AhmedSobhy01/convolution-accelerator/README.md

# Convolution Accelerator

A high-performance hardware accelerator for 2D convolution operations, designed as part of the **CMP3020 VLSI course**. This project implements a streaming coprocessor architecture that efficiently performs convolution operations under tight on-chip memory constraints.

## 📋 Table of Contents

- [Overview](#overview)
- [Project Features](#project-features)
- [Architecture](#architecture)
- [Project Structure](#project-structure)
- [Getting Started](#getting-started)
- [Physical Implementation (RTL-to-GDS)](#physical-implementation-rtl-to-gds)
- [Design Specifications](#design-specifications)
- [Documentation](#documentation)
- [Future Work](#future-work)
- [Team Contributions](#team-contributions)

---

## Overview

This project presents a **Weight Stationary (WS) dataflow** architecture optimized for 2D convolution acceleration. Rather than implementing a straightforward convolution approach, the design evolved through analysis, failed assumptions, and trade-offs, much like a real hardware development process.

### Key Innovation

The accelerator addresses the challenge of limited on-chip memory by:
- Using kernel folding to decompose large kernels (up to 16×16) into smaller blocks (8×8)
- Accumulating partial results across multiple passes
- Employing a split-kernel approach that distributes computation across multiple phases

### Use Case

The accelerator is designed as a streaming coprocessor that:
- Accepts input image and kernel data from external DRAM
- Performs efficient 2D convolution operations
- Returns output results to DRAM
- Works in tight integration with a host system

---

## Project Features

### 🔧 Core Components

- **8×8 Systolic Array** - Parallel processing element array for MAC operations
- **Dual-Port SRAM Architecture** - Concurrent read/write for efficient data movement
  - SRAM0 (64-bit × 1024): Image and kernel storage
  - SRAM1 (32-bit × 4096): Packed partial output buffer
- **DMA-Based Data Loading** - Efficient data movement from external DRAM
- **Split-Kernel Support** - Handles kernels up to 16×16 on 8×8 array
- **Column-Major Output** - Memory-efficient streaming of results
- **Control Unit FSM** - Orchestrates complex multi-phase kernel execution

### 📊 Performance Metrics

Signed off with **OpenLane 2 / SkyWater sky130A** at an 80 ns (12.5 MHz) clock:
DRC-clean, LVS-clean, and timing met. Full details in
[Physical_Implementation.md](docs/Physical_Implementation.md) and [Metrics.md](docs/Metrics.md).

| Metric | Value |
|---|---|
| DRC (KLayout `sky130A_mr`) | 0, pass |
| LVS (Netgen) | 0 errors, pass |
| Setup slack (slow corner) | +13.0 ns, met |
| Hold | met |
| Total power at 80 ns | 0.091 W |
| Die / core area | 18.0 / 17.1 mm² |
| Core utilization | 28.3% |
| SRAM macros | 20 (4 of 32×512, 16 of 32×256) |
| Array dimension | 8×8 |
| Max kernel size | 16×16 |
| Supported image size | up to 64×64 |

---

## Architecture

### System Overview

ba5d1150-3803-4dfe-b6b3-72ebcee24833

### Data Flow Phases

1. **Load Phase**: DRAM image and kernel loaded into SRAM0 via DMA
2. **Kernel Streaming**: 8×8 kernel blocks streamed to systolic array
3. **Convolution**: SA computes partial contributions for each kernel block
4. **Writeback**: Partial results accumulated in SRAM1 using byte-masked writes
5. **Drain Phase**: Final results summed and streamed back to DRAM

### Split-Kernel Approach

For kernels larger than 8×8:
- **Phase A**: Top-left 8×8 kernel block → partial output
- **Phase B**: Top-right 8×8 kernel block → accumulated
- **Phase C**: Bottom-left 8×8 kernel block → accumulated
- **Phase D**: Bottom-right 8×8 kernel block → accumulated

Final output = sum of all partial contributions

---

## Project Structure

```
convolution-accelerator/
├── rtl/                           # RTL Design Files (Verilog)
│   ├── conv_accelerator_top.v     # Top-level module
│   ├── control_unit/              # FSM-based control unit
│   ├── data-loader-agu/           # Data loader and AGU
│   │   ├── src/                   # Core streaming modules
│   │   ├── Python_scripts/        # Helper scripts for memory generation
│   │   └── designs/               # SRAM design files
│   ├── systolic_array/            # Systolic array implementation
│   │   ├── pe.v                   # Processing element
│   │   └── systolic_array.v       # 8×8 array
│   └── tb/                        # Testbenches
│
├── config/                        # OpenLane hardening configuration
│   ├── config.json                # RTL-to-GDS flow parameters
│   ├── macro_placement.cfg        # SRAM macro placement
│   └── runs/                      # Generated flow runs (output, git-ignored)
│
├── docs/                          # Documentation (architecture, metrics, flow)
│
├── scripts/                       # Simulation + verification scripts
│   └── run_all_tests.py, verify*  # Functional test/verify helpers
│
├── test_cases/                    # Test configurations (01 -> 10)
│
└── sim/                           # Simulation scripts
```

---

## Getting Started

### Prerequisites

- **Verilog/SystemVerilog** simulator (ModelSim, VCS, etc.)
- **Python 3.x** (for test generation and verification scripts)
- **Make** or equivalent build tool (optional)

### Running Simulations

#### 1. Simulate Individual Components

**Systolic Array Test:**
```bash
cd rtl/systolic_array
vsim -do ../../sim/systolic_array_sim.do
```

**Processing Element Test:**
```bash
cd rtl/systolic_array
vsim -do ../../sim/pe_sim.do
```

**Control Unit Test:**
```bash
cd rtl/control_unit
vsim -do run_tb.do
```

#### 2. Run Full System Tests

```bash
cd scripts
python3 run_all_tests.py
```

This will:
- Load test configurations from `test_cases/`
- Generate stimulus data
- Run full integration simulations
- Compare outputs with golden references

#### 3. Verify Output

```bash
bash scripts/verify.sh
```

### Physical Implementation (RTL-to-GDS)

The accelerator is hardened to GDSII with **OpenLane 2** on the **SkyWater
sky130A** PDK. The flow is driven by `config/config.json` and produces a
**DRC-clean, LVS-clean, timing-met** layout. See
[docs/Physical_Implementation.md](docs/Physical_Implementation.md) for the full
flow, configuration rationale, and the SRAM-macro signoff fixes.

```bash
# Launch the full RTL-to-GDS flow (output lands in config/runs/<tag>/)
openlane config/config.json --run-tag my_run

# Follow the live flow log
tail -f config/runs/my_run/flow.log
```

A run succeeds when `config/runs/<tag>/final/` appears, containing
`final/gds/conv_accelerator_top.gds` plus DEF/LEF/LIB/SDC/SDF/SPEF/SPICE views.

---

## Design Specifications

### Top-Level Module: `conv_accelerator_top`

#### Parameters
| Parameter | Default | Description |
|---|---|---|
| `ADDR_W` | 10 | SRAM0 word address width (1024 words) |
| `BYTE_ADDR_W` | 13 | Byte address width (8 KB) |
| `KER_BASE_BYTE` | 4096 | Kernel base address in SRAM0 |
| `IMG_BASE_BYTE` | 0 | Image base address in SRAM0 |
| `SRAM1_ADDR_W` | 12 | SRAM1 word address width (4096 words) |
| `SA_DIM` | 8 | Systolic array dimension |
| `SA_INPUT_FILL_TIME` | 8 | SA pipeline fill time |

#### Port Interface

```verilog
// Inputs
input clk                    // System clock
input rst_n                  // Active-low reset
input start                  // Start convolution operation
input [6:0] cfg_N           // Image dimension (N×N)
input [4:0] cfg_K           // Kernel dimension (K×K)
input [7:0] rx_data         // Input data from DRAM
input rx_valid              // Input data valid signal
input tx_ready              // Output ready signal

// Outputs
output done                 // Convolution complete
output rx_ready             // Ready to accept input data
output tx_valid             // Output data valid
output [7:0] tx_data        // Output data to DRAM
```

### Memory Architecture

#### SRAM0 (64-bit × 1024 words)
- Stores full input image and kernel weights
- Dual-port for concurrent reads
- Image stored from address 0
- Kernel stored from address 4096 (configurable)

#### SRAM1 (32-bit × 4096 words)
- Stores packed partial outputs
- 4 bytes per pixel (one byte per kernel phase)
- Byte-masked writes enable atomic lane updates
- No read-modify-write cycles required

### Timing Constraints

The hardened design closes timing cleanly at an **80 ns clock (12.5 MHz)**:

| Metric | Value |
|---|---|
| Clock period | 80 ns (12.5 MHz) |
| Worst Setup Slack (slow corner) | +13.0 ns, met |
| Setup / Hold violations | 0 / 0 |

> The clock was tightened from an earlier 150 ns point, which met timing with
> about 46 ns of unused slack. 80 ns is the fastest clean operating point from
> configuration alone. Going faster (70 ns) keeps setup positive but introduces
> small hold violations, so beyond 80 ns needs RTL pipelining of the
> systolic-array drain path.

---
## Key Design Decisions

### Weight Stationary Dataflow

The final architecture employs **Weight Stationary (WS)** rather than Output Stationary (OS) because:
- Kernel is reused across the entire input image
- Keeping weights fixed in PEs minimizes redundant weight movement
- Simplifies kernel loading and reduces data communication
- Well-suited for single-kernel, large-input-image scenarios

### Split-Kernel Approach

For kernels larger than 8×8:
- Decompose into 8×8 sub-kernels
- Process sequentially through multiple phases
- Accumulate partial outputs in SRAM1
- Final results obtained by summing all partial contributions

### Dual-Port SRAM Strategy

- **SRAM0 (64-bit)**: Optimized for unaligned window reads and kernel loading
- **SRAM1 (32-bit)**: Packed output format with byte-lane isolation
- Enables pipelined data movement without pipeline stalls

## Documentation

For detailed information, refer to the documentation files:

- **[Comprehensive_Architecture.md](docs/Comprehensive_Architecture.md)** - Complete system architecture and module descriptions
- **[Convolution Accelerator.md](docs/Convolution%20Accelerator.md)** - Project journey, design decisions, and architectural evolution
- **[Memory Organization.md](docs/Memory%20Organization.md)** - SRAM layout, address generation, and memory mapping
- **[Control Unit.md](docs/Control%20Unit.md)** - FSM design and state transitions
- **[Systolic Array Documentation](docs/Systolic%20Array/)** - Detailed PE and array specifications
- **[Physical_Implementation.md](docs/Physical_Implementation.md)** - RTL-to-GDS (OpenLane/sky130) flow, configuration, and signoff fixes
- **[Metrics.md](docs/Metrics.md)** - PPA (Power, Performance, Area) & signoff results
- **[Team_Contributions.md](docs/Team_Contributions.md)** - Team member roles and module ownership

---
## Future Work
The team is currently looking into 2 other implementations that are expected to improve the performance metrics even more.

1) DiP Architectured systolic arrays\
Referenced from this paper: https://arxiv.org/pdf/2412.09709 \
current work can be found in this branch: [feat/sa-dip](https://github.com/AhmedSobhy01/convolution-accelerator/tree/feat/sa-dip)\
It basically works by eliminating the input/output synchronization FIFOs required by state-of-the-art weight stationary systolic arrays by adopting diagonal input movement and weight permutation.



2) A slight timing adjustment on the current 101 implementation\
Inspired after reading this article: https://telesens.co/2018/07/30/systolic-architectures \
current work progress can be found in this branch: [feat/sa-101-optimized](https://github.com/AhmedSobhy01/convolution-accelerator/tree/feat/sa-101-optimized)

---
## References

This project implements concepts from CNN accelerator literature, including:
- Systolic array design principles
- Dataflow mapping techniques for convolution
- Memory hierarchy optimization for embedded systems

---
## Team Contributions

<table align="center">
<tr>
  <td align = "center"> 
	<a href = "https://github.com/AhmedSobhy01">
	  
	  <br />
	  <sub> Ahmed Sobhy </sub>
	</a>
  </td>

  <td align = "center"> 
	<a href = "https://github.com/AhmedAmrNabil">
	  
	  <br />
	  <sub> AhmedAmrNabil </sub>
	</a>
  </td>
  
  <td align = "center"> 
	<a href = "https://github.com/ahmedfathy0-0">
	  
	  <br />
	  <sub> Ahmed Fathy </sub>
	</a>
  </td>

  <td align = "center"> 
	<a href = "https://github.com/ZiadMontaser">
	  
	  <br />
	  <sub> Ziad Montaser</sub>
	</a>
  </td>
</tr>
</table>

<table align="center">
<tr>

  <td align = "center"> 
	<a href = "https://github.com/Tasneemmohammed0">
	  
	  <br />
	  <sub> Tasneem Mohamed </sub>
	</a>
  </td>
  
  <td align = "center"> 
	<a href = "https://github.com/habibayman">
	  
	  <br />
	  <sub> Habiba Ayman </sub>
	</a>
  </td>
  <td align = "center"> 
	<a href = "https://github.com/tonynagyy">
	  
	  <br />
	  <sub> Tony Nagy </sub>
	</a>
  </td>

  <td align = "center"> 
	<a href = "https://github.com/HelanaNady">
	  
	  <br />
	  <sub> Helana Nady</sub>
	</a>
  </td>
</tr>
</table>
