AhmedSobhy01/convolution-accelerator/rtl/data-loader-agu/designs/SRAM_32_4096_1_grid/32x4096-MT-32x256.png

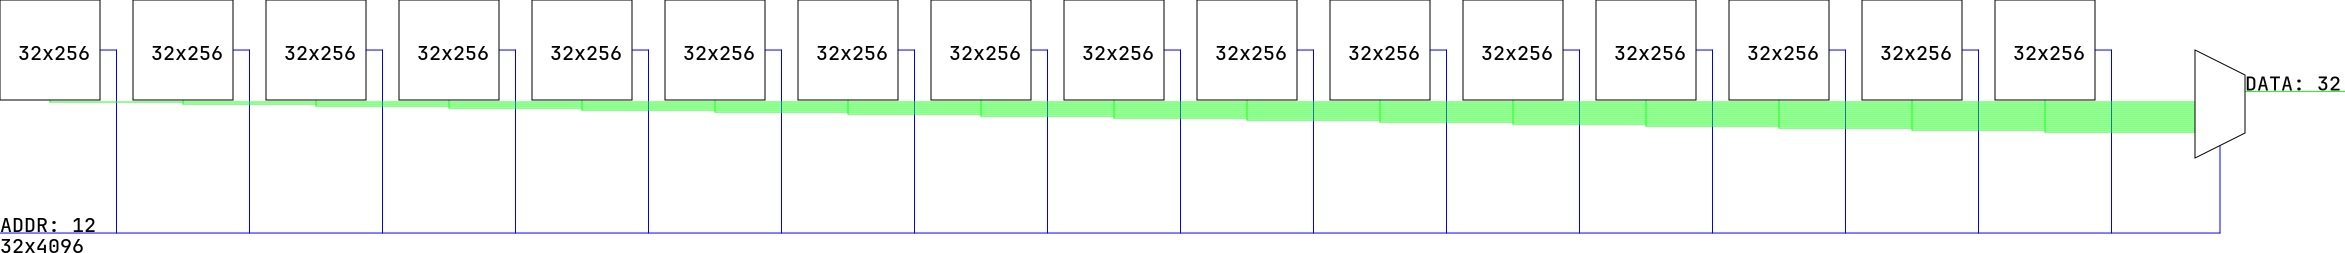
rtl/data-loader-agu/designs/SRAM_32_4096_1_grid/32x4096-MT-32x256.png
