AhmedSobhy01/convolution-accelerator/rtl/data-loader-agu/designs/SRAM_64_1024_2_grid/64x1024-MT-32x512.png

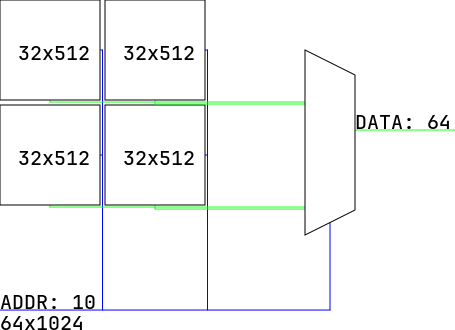
rtl/data-loader-agu/designs/SRAM_64_1024_2_grid/64x1024-MT-32x512.png
