AhmedSobhy01/convolution-accelerator/docs/Team Contributions.pdf

## Convolution Accelerator - Team Contributions

## Project Team

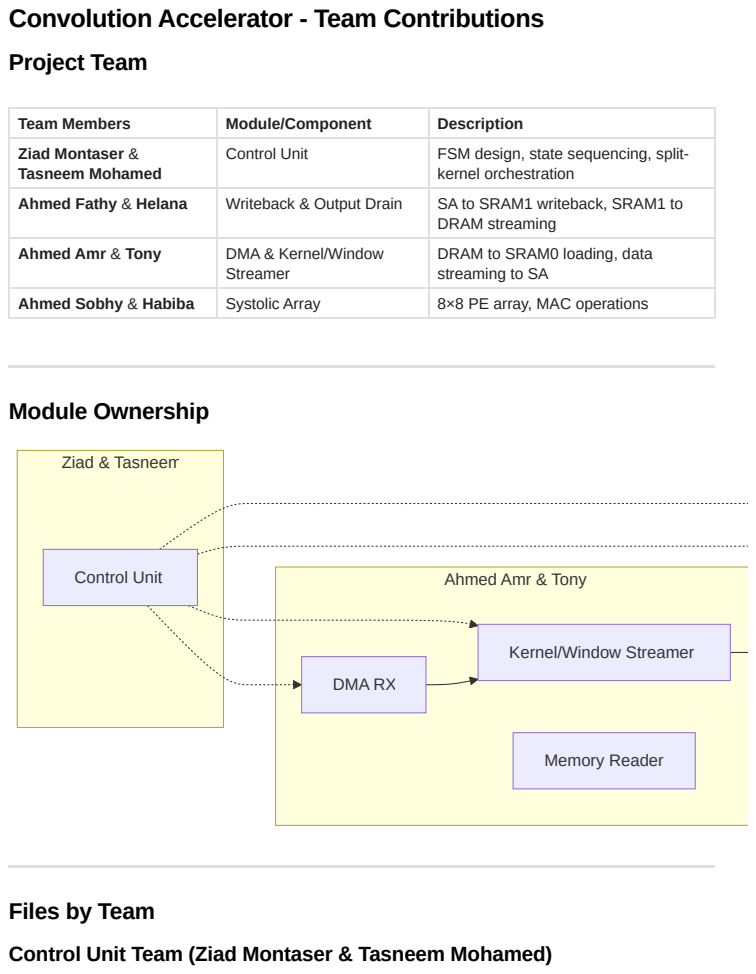
[picture p3: page 1]
Module Ownership; Ziad & Tasneem; Control Unit; DMA RX; Memory Reader

Team Members | Module/Component | Description
Ziad Montaser & Tasneem Mohamed | Control Unit | FSM design, state sequencing, split-kernel orchestration

Ahmed Fathy & Helana | Writeback & Output Drain | SA to SRAM1 writeback, SRAM1 to DRAM streaming

Ahmed Amr & Tony | DMA & Kernel/Window Streamer | DRAM to SRAM0 loading, data streaming to SA

Ahmed Sobhy & Habiba | Systolic Array | 8×8 PE array, MAC operations

Ahmed Amr & Tony

Kernel/Window Streamer

Files by Team

Control Unit Team (Ziad Montaser & Tasneem Mohamed)

## DMA & Streamer Team (Ahmed Amr & Tony)

## Systolic Array Team (Ahmed Sobhy & Habiba)

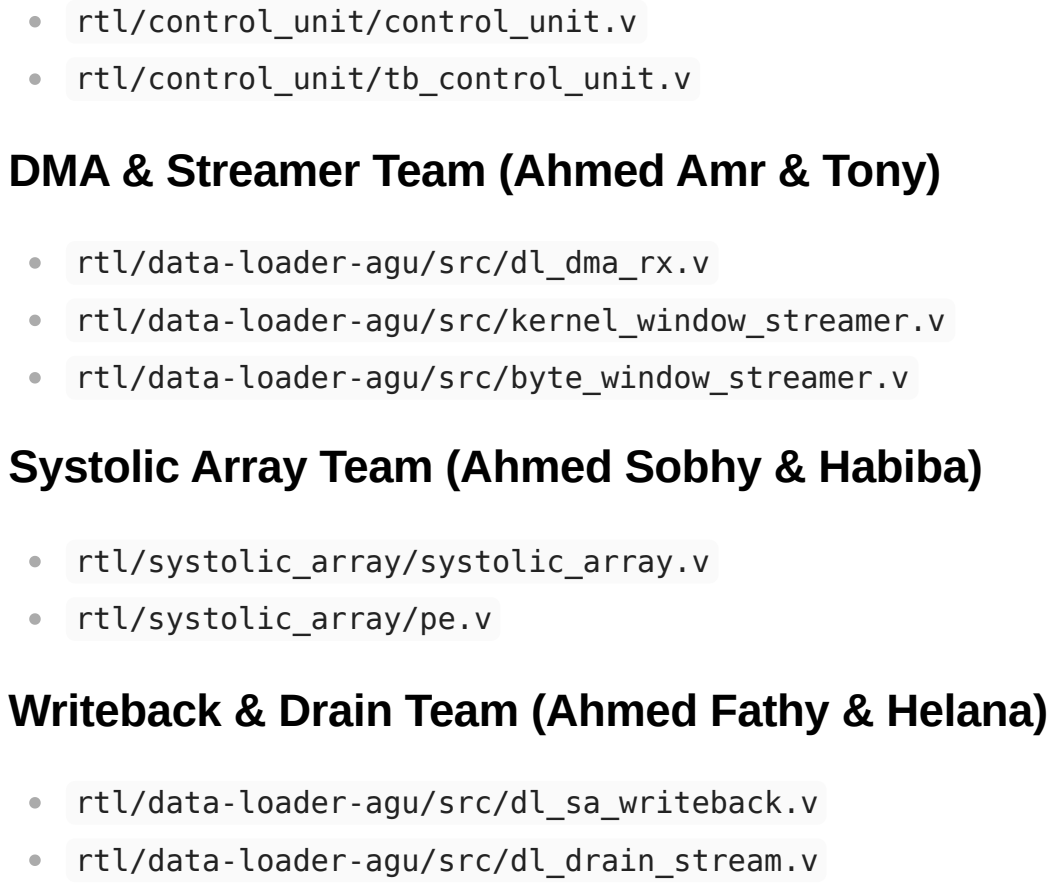
[picture p4: page 2]
rtl/control_unit/control_unit.v; rtl/control_unit/tb_control_unit.v

rtl/data-loader-agu/src/dl_dma_rx.v
rtl/data-loader-agu/src/kernel_window_streamer.v
rtl/data-loader-agu/src/byte_window_streamer.v

rtl/systolic_array/systolic_array.v
rtl/systolic_array/pe.v
Writeback & Drain Team (Ahmed Fathy & Helana)

rtl/data-loader-agu/src/dl_sa_writeback.v
rtl/data-loader-agu/src/dl_drain_stream.v
