AhmedSobhy01/convolution-accelerator/docs/Comprehensive Architecture.pdf

# Convolution Accelerator - Comprehensive Architecture Documentation

## Table of Contents

## System Overview

This convolution accelerator is a hardware implementation for 2D convolution operations, commonly used in CNNs. It processes an N×N image with a K×K kernel to produce an (N-K+1)×(N-K+1) output.

## Key Features

1. System Overview
2. Top-Level Architecture
3. Data Flow Pipeline
4. Module Deep Dive
5. Testbench Operation
6. Timing & Control

8×8 Systolic Array for parallel MAC operations
Dual-port SRAM architecture for concurrent read/write DMA-based data loading from external DRAM Split-kernel support for kernels larger than 8×8 (up to 16×16) Column-major output for memory-efficient streaming

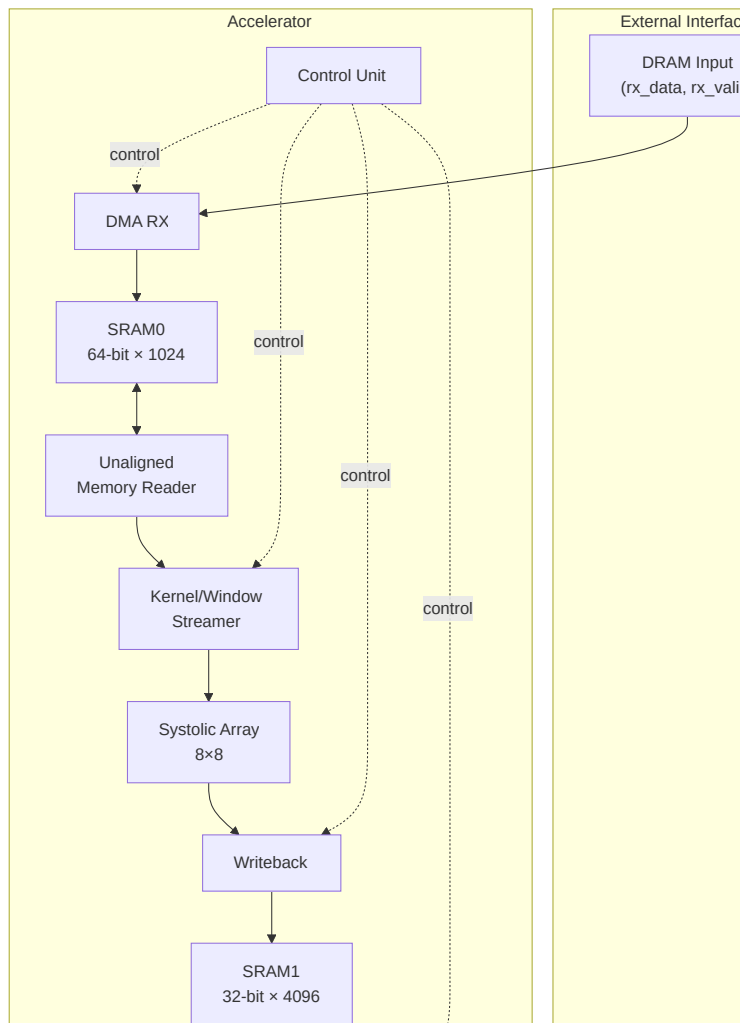
[picture p5: page 2]
Accelerator; External Interfac; control; DRAM Input (rx_data, rx_vali; DMA RX; SRAM0 64-bit × 1024; Unaligned Memory Reader; Kernel/Window Streamer; Systolic Array 8×8; Writeback; SRAM1 32-bit × 4096; Control Unit

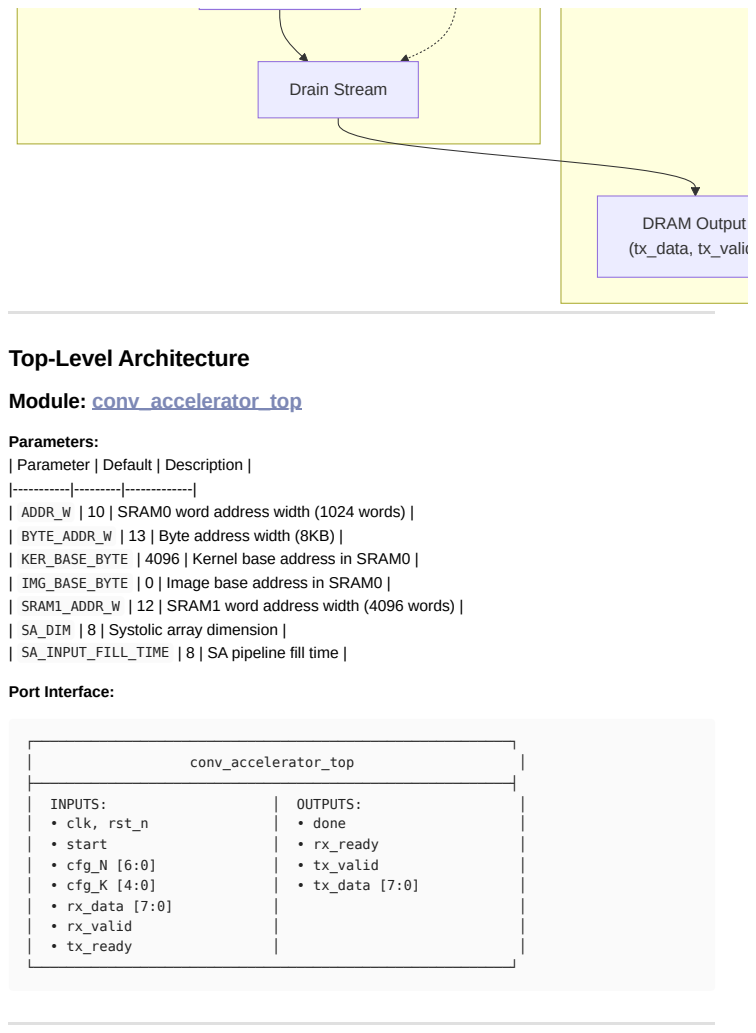
[picture p6: page 3]
DRAM Output (tx_data, tx_valid; Drain Stream; Module: conv_accelerator_top; Port Interface:; conv_accelerator_top; │ INPUTS:; │ OUTPUTS:; │ • clk, rst_n; │ • done; │ • start; │ • rx_ready; │ • cfg_N [6:0]; │ • tx_valid; │ • cfg_K [4:0]; │ • tx_data [7:0]; │ • rx_data [7:0]; │ • rx_valid; │ • tx_ready

Top-Level Architecture

Parameters:
Parameter | Default | Description
ADDR_W | 10 | SRAM0 word address width (1024 words)
BYTE_ADDR_W | 13 | Byte address width (8KB)
KER_BASE_BYTE | 4096 | Kernel base address in SRAM0
IMG_BASE_BYTE | 0 | Image base address in SRAM0
SRAM1_ADDR_W | 12 | SRAM1 word address width (4096 words)
SA_DIM | 8 | Systolic array dimension
SA_INPUT_FILL_TIME | 8 | SA pipeline fill time

## Data Flow Pipeline

## Phase 1: Data Loading (DRAM → SRAM0)

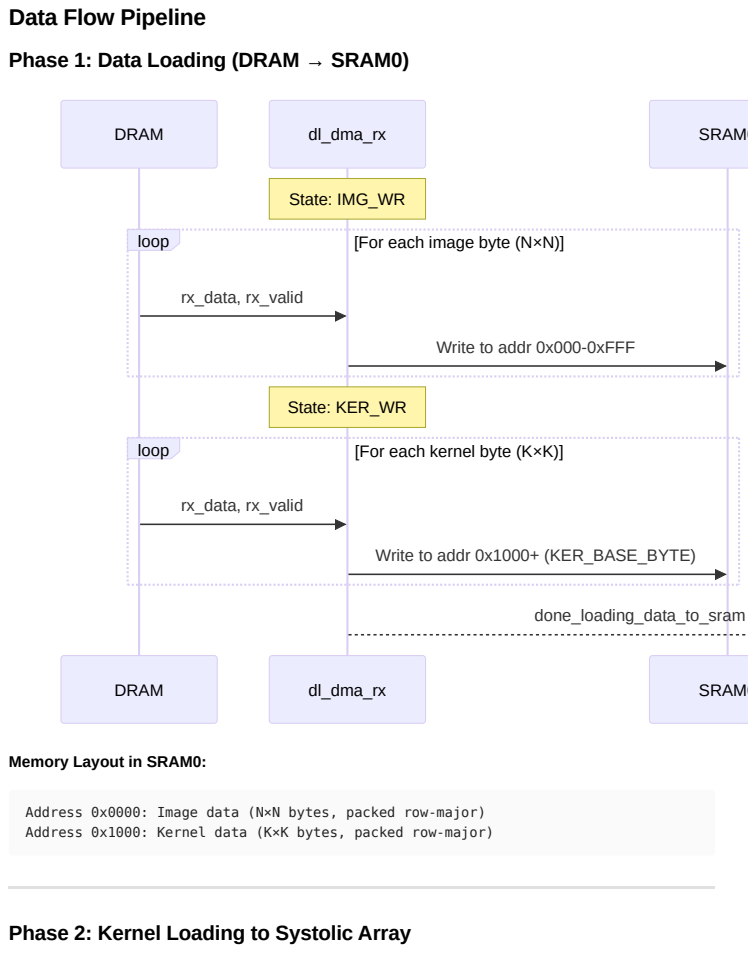
[picture p7: page 4]
DRAM; dl_dma_rx; SRAM0; State: IMG_WR; loop; [For each image byte (N×N)]; State: KER_WR; [For each kernel byte (K×K)]; rx_data, rx_valid; done_loading_data_to_sram

Write to addr 0x000-0xFFF

Write to addr 0x1000+ (KER_BASE_BYTE)

Memory Layout in SRAM0:

Address 0x0000: Image data (N×N bytes, packed row-major)
Address 0x1000: Kernel data (K×K bytes, packed row-major)

Phase 2: Kernel Loading to Systolic Array

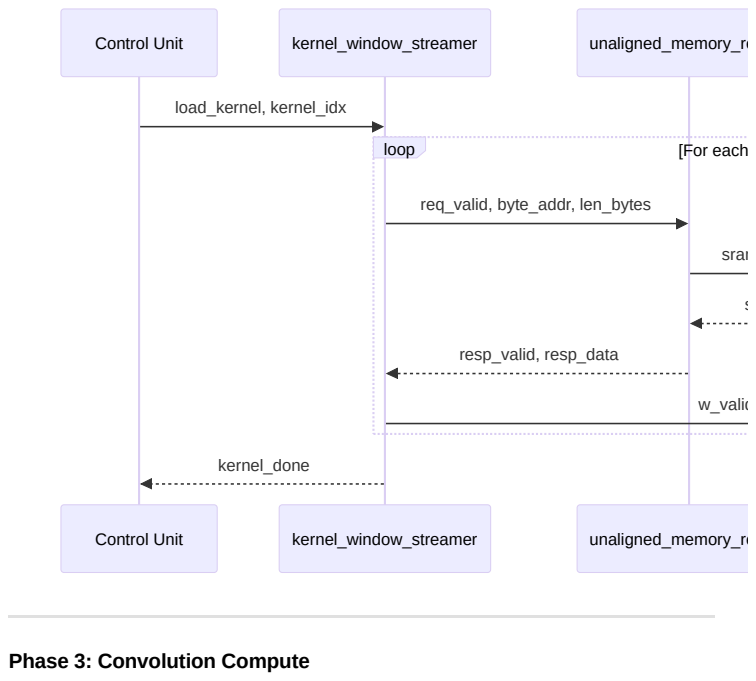
[picture p8: page 5]
Control Unit; kernel_window_streamer; unaligned_memory_re; loop; [For each; load_kernel, kernel_idx; req_valid, byte_addr, len_bytes; sram; resp_valid, resp_data; w_valid; kernel_done

Phase 3: Convolution Compute

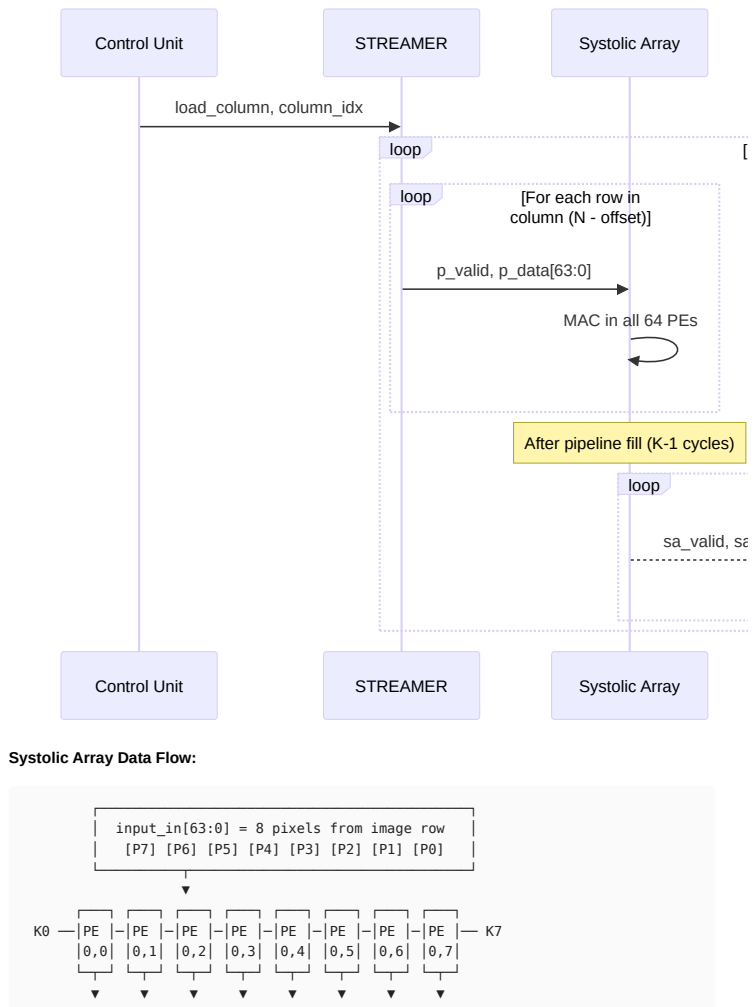
[picture p9: page 6]
Control Unit; STREAMER; Systolic Array; loop; [For each row in; column (N - offset)]; load_column, column_idx; p_valid, p_data[63:0]; sa_valid, sa; │ input_in[63:0] = 8 pixels from image row

MAC in all 64 PEs

After pipeline fill (K-1 cycles)

Systolic Array Data Flow:

## Phase 4: Result Drain (SRAM1 → DRAM)

┌───┐ ┌───┐ ┌───┐ ┌───┐ ┌───┐ ┌───┐ ┌───┐ ┌───┐
K8 ──│PE │─│PE │─│PE │─│PE │─│PE │─│PE │─│PE │─│PE │── K15 │1,0│ │1,1│ │1,2│ │1,3│ │1,4│ │1,5│ │1,6│ │1,7│ └─┬─┘ └─┬─┘ └─┬─┘ └─┬─┘ └─┬─┘ └─┬─┘ └─┬─┘ └─┬─┘
⋮ | ⋮ | ⋮ | ⋮ | ⋮ | ⋮ | ⋮ | ⋮

Each PE: out_partial = kernel_weight × input_pixel
Sum of all 64 partials → output pixel (clamped to 8 bits)

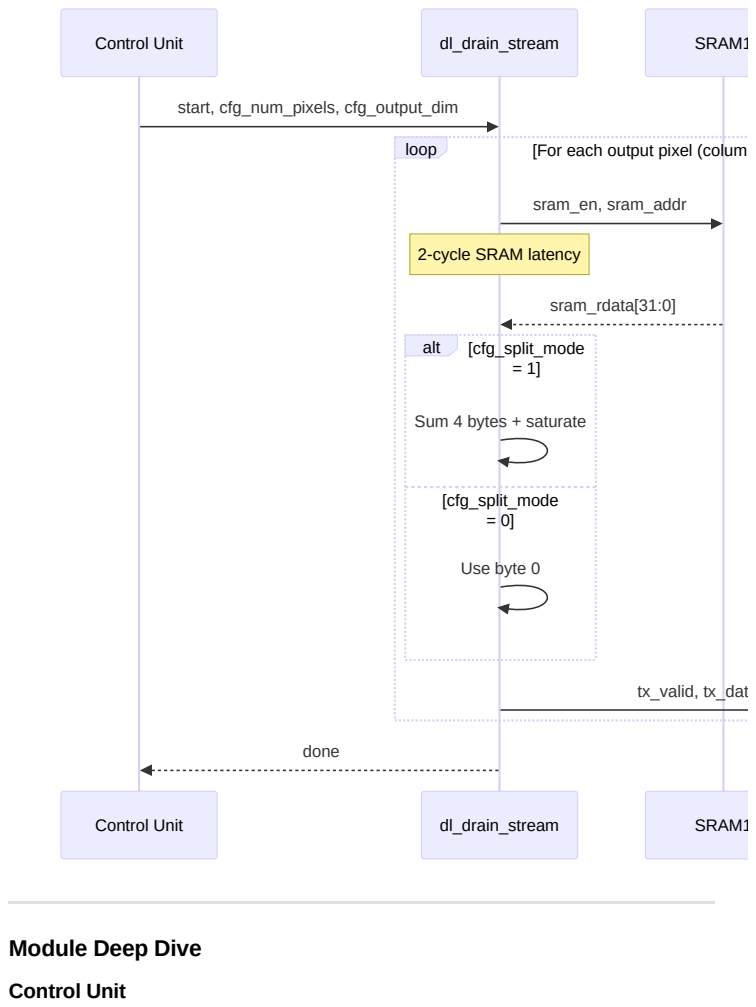
[picture p10: page 8]
Control Unit; dl_drain_stream; SRAM1; alt; [cfg_split_mode; [cfg_split_mode = 0]; loop; [For each output pixel (colum; start, cfg_num_pixels, cfg_output_dim; sram_en, sram_addr; sram_rdata[31:0]; Use byte 0; tx_valid, tx_dat; done

2-cycle SRAM latency

Sum 4 bytes + saturate

Module Deep Dive

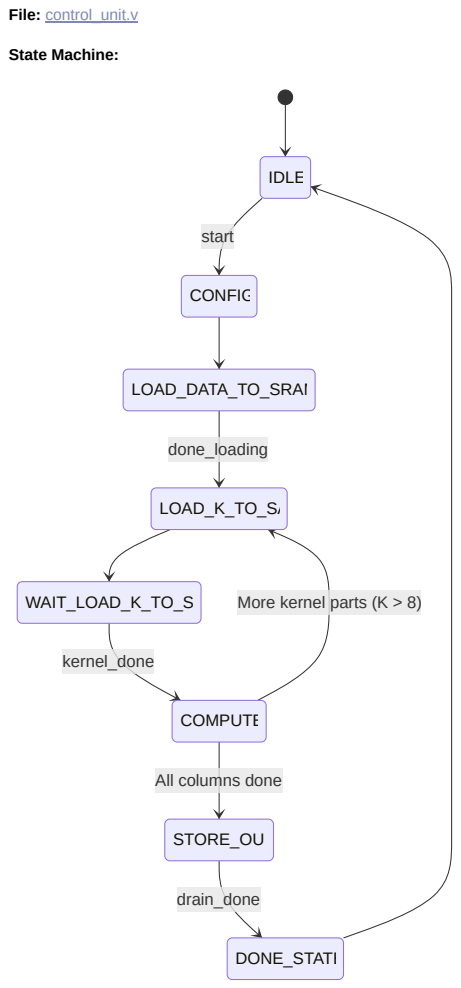
[picture p11: page 9]
File: control_unit.v; State Machine:; start; done_loading; kernel_done; drain_done; IDLE; CONFIG; LOAD_DATA_TO_SRAM; LOAD_K_TO_SA; WAIT_LOAD_K_TO_S; COMPUTE; STORE_OU; DONE_STATE

More kernel parts (K > 8)

All columns done

Split-Kernel Support (K > 8):
When kernel size exceeds SA dimension, kernel is split into 4 quadrants:

## DMA RX Module

File: dl_dma_rx.v

Receives byte-wide data from DRAM and packs into 64-bit SRAM words.

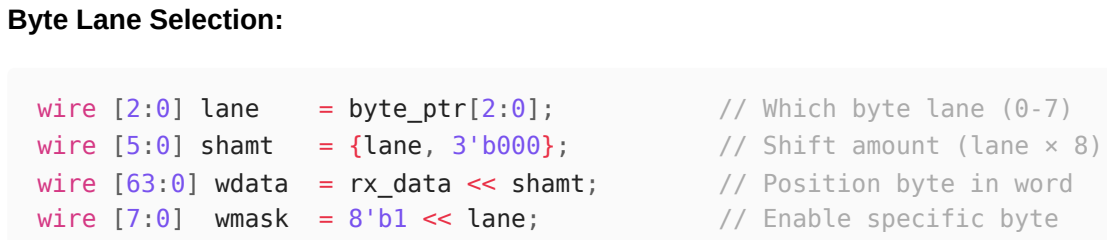
[picture p12: figure]
Byte Lane Selection:; wire [2:0] lane; = byte_ptr[2:0];; // Which byte lane (0-7)

## Unaligned Memory Reader

File: byte_window_streamer.v

Reads arbitrary byte-aligned data from 64-bit SRAM. Uses both SRAM ports to handle cross-word-boundary reads.

┌───────────────┬───────────────┐
│ Quadrant 0 | │ Quadrant 1 | │
│ (idx=0) | │ (idx=1) | │
│ Top-Left | │ Top-Right | │
├───────────────┼───────────────┤
│ Quadrant 2 | │ Quadrant 3 | │
│ (idx=2) | │ (idx=3) | │
│ Bottom-Left | │ Bottom-Right │
└───────────────┴───────────────┘
wire [5:0] shamt | = {lane, 3'b000}; | // Shift amount (lane × 8)
wire [63:0] wdata = rx_data << shamt; | // Position byte in word
wire [7:0] wmask = 8'b1 << lane; | // Enable specific byte

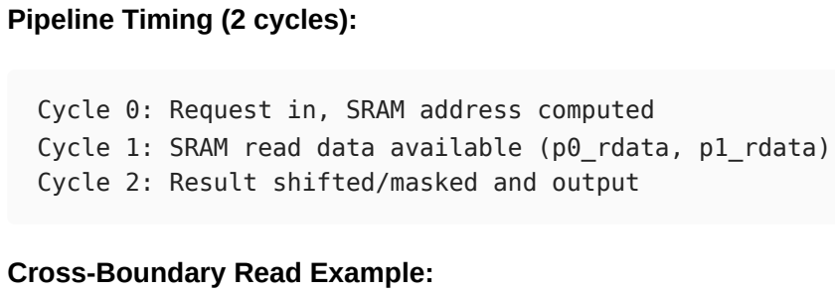
[picture p13: figure]
Pipeline Timing (2 cycles):; Cross-Boundary Read Example:

Cycle 0: Request in, SRAM address computed
Cycle 1: SRAM read data available (p0_rdata, p1_rdata) Cycle 2: Result shifted/masked and output

## Kernel/Window Streamer

File: kernel_window_streamer.v

Orchestrates data streaming for both kernel loading and image window streaming.

Two Modes:

## Processing Element (PE)

File: pe.v

Each PE performs a single multiply operation per cycle.

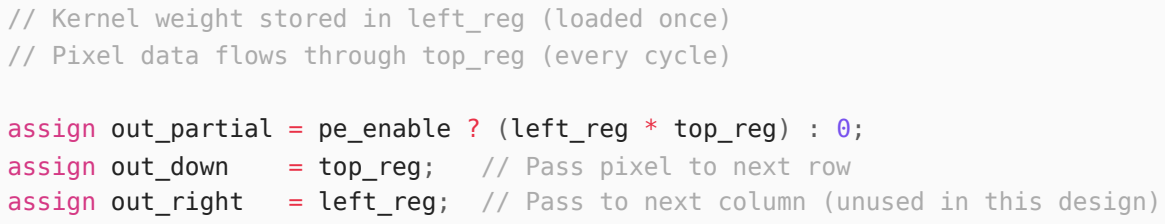
[picture p14: figure]

## Systolic Array

File: systolic_array.v

8×8 array of PEs computing dot product of kernel × image window.

Output Computation:

SRAM Word N+1: [B7 B6 B5 B4 B3 B2 B1 B0]

Combined: | [Word N+1 | Word N] >> 40 & 0xFFFFFFFF
1. LOAD_KERNEL: Reads kernel rows from KER_BASE_BYTE
2. STREAM_WIN: Reads image columns from IMG_BASE_BYTE + column offset

// Kernel weight stored in left_reg (loaded once)
// Pixel data flows through top_reg (every cycle)

assign out_partial = pe_enable ? (left_reg * top_reg) : 0;
assign out_down | = top_reg; | // Pass pixel to next row
assign out_right | = left_reg; // Pass to next column (unused in this design)

// Sum all 64 partial products always @(*) begin

## SA Writeback

File: dl_sa_writeback.v

Buffers SA outputs and writes to SRAM1 using byte-lane masking for split-kernel accumulation.

FIFO Buffer: 8-entry × 8-bit to absorb SA output burst

Address Stride: Increments by 1 word per write (kernel_idx selects byte lane for accumulation)

## Drain Stream

File: dl_drain_stream.v

Reads output from SRAM1 and streams to DRAM byte-by-byte.

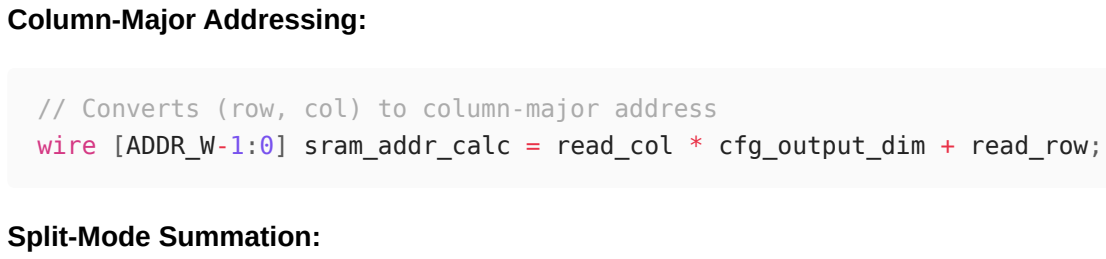
[picture p15: figure]
Column-Major Addressing:; Split-Mode Summation:

When K > 8, four partial results are summed with saturation:

## Testbench Operation

## File: tb_conv_accel_simple.v

Test Case Structure:

sum_partials = 0;
for (n = 0; n < 8; n = n + 1) for (m = 0; m < 8; m = m + 1)
sum_partials = sum_partials + pe_out_partials[n][m]; end

// Converts (row, col) to column-major address
wire [ADDR_W-1:0] sram_addr_calc = read_col * cfg_output_dim + read_row;

sum_temp = sram_rdata[7:0] + sram_rdata[15:8] +

computed_pixel = (sum_temp > 255) ? 8'hFF : sum_temp[7:0];

Test Flow:

test_cases/
├── 01_Basic_Minimal_config.txt ├── 01_Basic_Minimal_in.hex ├── 01_Basic_Minimal_weight.hex ├── 02_Basic_Identity_config.txt ├── ...
└── 10_Pro_Saturation_*.{txt,hex}

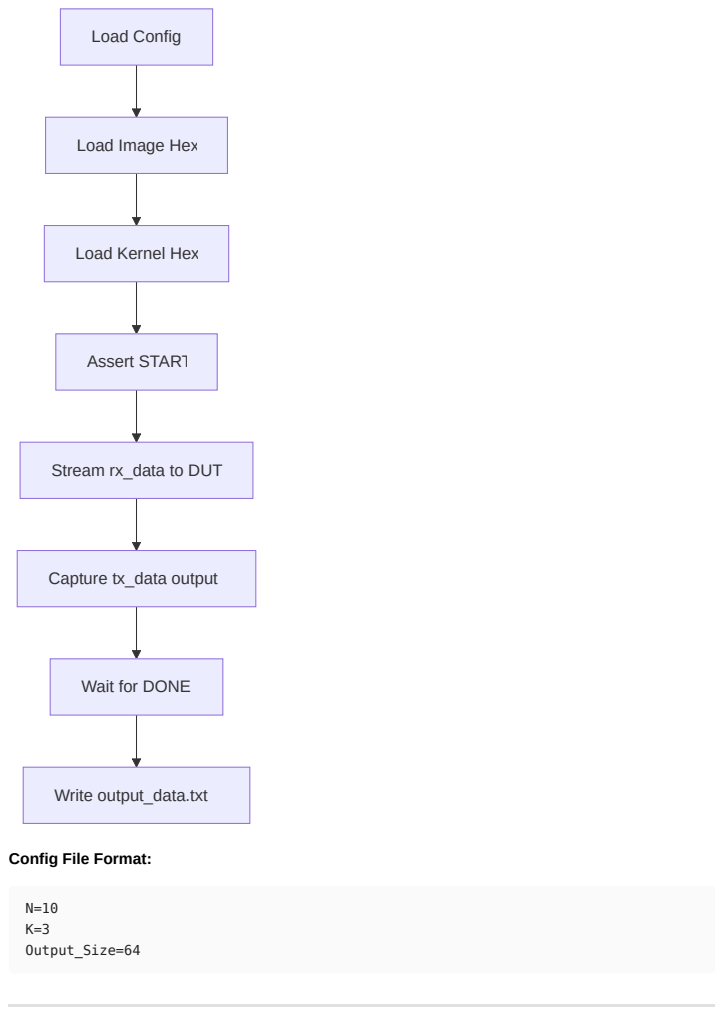
[picture p16: page 14]
Load Config; Assert START; Capture tx_data output; Write output_data.txt; N=10 K=3 Output_Size=64

Load Image Hex

Load Kernel Hex

Stream rx_data to DUT

Wait for DONE

Config File Format:

## Timing & Control

## Pipeline Latency Summary

Stage | Latency (cycles)
DMA Write to SRAM | 1
Memory Reader | 2
SA Pipeline Fill | K-1 (or half-K for split)
SA Valid Delay | SA_INPUT_FILL_TIME + SA_DIM
Writeback FIFO | 0-8 (depends on fill)
Drain SRAM Read | 2

## Control Signals Timing

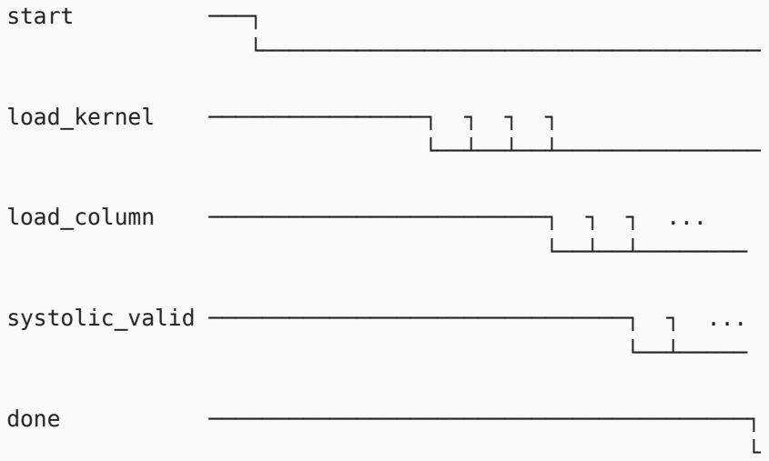
[picture p17: figure]
start; load_kernel; load_column; systolic_valid ───────────────────────────────┐ ┐ ... └──┴─────; done

## Memory Map

## SRAM0 (Input Buffer - 8KB)

Address Range | Content
0x0000 - 0x0FFF | Image data (N×N bytes)
0x1000 - 0x10FF | Kernel data (K×K bytes)

## SRAM1 (Output Buffer - 16KB)

Address Range | Content
0x000 - 0xFFF | Output pixels (column-major, 1 byte/word for normal, 4 bytes/word for split)

## Configuration Constraints

Parameter | Min | Max | Notes
N (Image Size) | 2 | 64 | Power of 2 recommended
K (Kernel Size) | 1 | 16 | Split mode for K > 8
Output Size | 1 | 63 | = N - K + 1
