AhmedSobhy01/convolution-accelerator/rtl/conv_accelerator_top.v

`timescale 1ns/1ps

module conv_accelerator_top #(
  parameter ADDR_W = 10,              // SRAM0 word address width (1024 words)
  parameter BYTE_ADDR_W = 13,         // Byte address width (8KB)
  parameter KER_BASE_BYTE = 16'd4096,
  parameter IMG_BASE_BYTE = 16'd0,
  parameter SRAM1_ADDR_W  = 12,       // SRAM1 word address width (4096 words)
  parameter SA_DIM = 8,               // Systolic array dimension
  parameter SA_INPUT_FILL_TIME = 8    // SA fill time
)(
  input  wire         clk,
  input  wire         rst_n,

  // High-level control interface
  input  wire         start,          // Start convolution operation
  input  wire [6:0]   cfg_N,          // Image size (control unit)
  input  wire [4:0]   cfg_K,          // Kernel size (control unit)
  output wire         done,           // Operation complete

  // DRAM input stream (32-bit) -> SRAM0
  input  wire [7:0]  rx_data,
  input  wire         rx_valid,
  output wire         rx_ready,

  // DRAM output stream (8-bit) <- SRAM1
  output wire         tx_valid,
  output wire [7:0]   tx_data,
  input  wire         tx_ready
`ifdef USE_POWER_PINS
  ,
  inout wire          vccd1,          // Power  (connected to PDN via VDD_NETS)
  inout wire          vssd1           // Ground (connected to PDN via GND_NETS)
`endif
);

  // Systolic Array Interface
  // Outputs TO SA
  wire         w_valid;        // kernel/weight data valid
  wire [63:0]  w_data;         // kernel column vector
  wire         p_valid;        // pixel data valid
  wire [63:0]  p_data;         // pixel row vector

  // Inputs FROM SA (Results)
  wire         sa_out_valid;
  wire [7:0]   sa_out_data;
  wire         sa_wb_busy;     // Writeback buffer full

  // ============================================
  // Power Pins
  // ============================================
  // vccd1/vssd1 are top-level inout ports (declared in the port list under
  // USE_POWER_PINS) and are hooked to the power grid by OpenLane via
  // VDD_NETS/GND_NETS. They must not be supply0/supply1 constants, otherwise
  // the SRAM macro power inouts get driven by constants (flatten error).

  // ============================================
  // Control Unit Signals
  // ============================================
  wire [6:0]   cu_cfg_N;
  wire [4:0]   cu_cfg_K;
  wire         cu_start_load;
  wire         cu_load_done;
  wire         cu_start_pass;
  wire         cu_load_kernel;
  wire [1:0]   cu_kernel_idx;
  wire         cu_kernel_done;
  wire         cu_load_column;
  wire [6:0]   cu_column_idx;
  wire         cu_start_drain;
  wire         cu_drain_done;
  wire         cu_systolic_valid;
  wire         window_done;      // streamer -> control unit column-load handshake

  // ============================================
  // SRAM0 Signals (Input Buffer)
  // ============================================
  wire         sram0_p0_en;
  wire         sram0_p0_we;
  wire [ADDR_W-1:0] sram0_p0_addr;
  wire [63:0]  sram0_p0_wdata;
  wire [7:0]   sram0_p0_wmask;
  wire [63:0]  sram0_p0_rdata;

  wire         sram0_p1_en;
  wire [ADDR_W-1:0] sram0_p1_addr;
  wire [63:0]  sram0_p1_rdata;

  // ============================================
  // SRAM1 Signals (Output Buffer)
  // ============================================
  wire         sram1_p0_en;
  wire         sram1_p0_we;
  wire [SRAM1_ADDR_W-1:0] sram1_p0_addr;
  wire [31:0]  sram1_p0_wdata;
  wire [3:0]   sram1_p0_wmask;
  wire [31:0]  sram1_p0_rdata; // Unused, port 0 is write-only here

  wire         sram1_p1_en;
  wire [SRAM1_ADDR_W-1:0] sram1_p1_addr;
  wire [31:0]  sram1_p1_rdata;

  // ============================================
  // Control Unit
  // ============================================
  control_unit #(
    .SA_DIM(SA_DIM),
    .SA_INPUT_FILL_TIME(SA_INPUT_FILL_TIME)
  ) u_control (
    .clk(clk),
    .rst_n(rst_n),
    .start(start),
    .cfg_N(cfg_N),
    .cfg_K(cfg_K),
    .done(done),
    .dl_cfg_N(cu_cfg_N),
    .dl_cfg_K(cu_cfg_K),
    .start_loading_data_to_sram(cu_start_load),
    .done_loading_data_to_sram(cu_load_done),
    .start_pass_dl(cu_start_pass),
    .load_kernel(cu_load_kernel),
    .kernel_index(cu_kernel_idx),
    .done_loading_kernel_to_sa(cu_kernel_done),
    .dl_output_data_valid(p_valid),
    .load_column(cu_load_column),
    .load_column_index(cu_column_idx),
    .done_loading_column_to_sa(window_done),
    .start_sending_output_to_dram(cu_start_drain),
    .done_sending_output_to_dram(cu_drain_done),
    .systolic_data_valid(cu_systolic_valid)
  );

  // ============================================
  // DMA Loader (writes to SRAM0)
  // ============================================
  wire         dma_sram_en;
  wire         dma_sram_we;
  wire [ADDR_W-1:0] dma_sram_addr;
  wire [63:0]  dma_sram_wdata;
  wire [7:0]   dma_sram_wmask;

  dl_dma_rx #(
    .ADDR_W(ADDR_W),
    .KER_BASE_BYTE(KER_BASE_BYTE)
  ) u_dma (
    .clk(clk),
    .rst_n(rst_n),
    .start(cu_start_load),
    .cfg_N(cu_cfg_N),
    .cfg_K(cu_cfg_K),
    .done(cu_load_done),
    .rx_data(rx_data),
    .rx_valid(rx_valid),
    .rx_ready(rx_ready),
    .sram0_en(dma_sram_en),
    .sram0_we(dma_sram_we),
    .sram0_addr(dma_sram_addr),
    .sram0_wdata(dma_sram_wdata),
    .sram0_wmask(dma_sram_wmask)
  );

  // ============================================
  // Unaligned Memory Reader (Reads SRAM0)
  // ============================================
  wire         reader_req_valid;
  wire [BYTE_ADDR_W-1:0] reader_byte_addr;
  wire [2:0]   reader_len_bytes;
  wire         reader_req_ready;
  wire         reader_resp_valid;
  wire [63:0]  reader_resp_data;

  wire         reader_p0_en;
  wire [ADDR_W-1:0] reader_p0_addr;
  wire         reader_p1_en;
  wire [ADDR_W-1:0] reader_p1_addr;

  unaligned_memory_reader #(
    .ADDR_W(BYTE_ADDR_W)
  ) u_reader (
    .clk(clk),
    .rst_n(rst_n),
    .req_valid(reader_req_valid),
    .byte_addr(reader_byte_addr),
    .len_bytes(reader_len_bytes),
    .req_ready(reader_req_ready),
    .resp_valid(reader_resp_valid),
    .resp_data(reader_resp_data),
    .sram_p0_en(reader_p0_en),
    .sram_p0_addr(reader_p0_addr),
    .sram_p0_rdata(sram0_p0_rdata),
    .sram_p1_en(reader_p1_en),
    .sram_p1_addr(reader_p1_addr),
    .sram_p1_rdata(sram0_p1_rdata)
  );

  // ============================================
  // Streamer Orchestrator
  // ============================================
  kernel_and_window_streamer #(
    .BYTE_ADDR_W(BYTE_ADDR_W),
    .KER_BASE_BYTE(KER_BASE_BYTE),
    .IMG_BASE_BYTE(IMG_BASE_BYTE)
  ) u_streamer (
    .clk(clk),
    .rst_n(rst_n),
    .cfg_N(cu_cfg_N),
    .cfg_K(cu_cfg_K),
    .start_load_kernel(cu_load_kernel),
    .kernel_idx(cu_kernel_idx),
    .kernel_done(cu_kernel_done),
    .start_stream_window(cu_load_column),
    .window_col(cu_column_idx),
    .window_done(window_done),
    .w_valid(w_valid),
    .w_data(w_data),
    .p_valid(p_valid),
    .p_data(p_data),
    .reader_req_valid(reader_req_valid),
    .reader_byte_addr(reader_byte_addr),
    .reader_len_bytes(reader_len_bytes),
    .reader_req_ready(reader_req_ready),
    .reader_resp_valid(reader_resp_valid),
    .reader_resp_data(reader_resp_data)
  );

  // ============================================
  // Systolic Array (8x8)
  // ============================================
  wire [31:0] sa_result;

  systolic_array #(
    .DATA_WIDTH(32),
    .ARRAY_SIZE(SA_DIM),
    .INPUT_WIDTH(8)
  ) u_systolic_array (
    .clk(clk),
    .rst(cu_start_load),
    .load_kernel_signal(w_valid),
    .p_valid(p_valid),
    .input_in(p_data),
    .kernel_in(w_data),
    .out_data(sa_result)
  );

  // Generate output valid signal (delayed to match SA pipeline)
  localparam SA_VALID_PIPE_DEPTH = SA_INPUT_FILL_TIME + SA_DIM;
  reg [SA_VALID_PIPE_DEPTH-1:0] sa_valid_pipe;
  always @(posedge clk or negedge rst_n) begin
    if (!rst_n)
      sa_valid_pipe <= 0;
    else
      sa_valid_pipe <= {sa_valid_pipe[SA_VALID_PIPE_DEPTH-2:0], (p_valid & w_valid)};
  end

  assign sa_out_data = (sa_result > 32'hFF) ? 32'hFF : sa_result[7:0]; // Take lower 8 bits

  // ============================================
  // Writeback (SA -> SRAM1)
  // ============================================
  dl_sa_writeback #(
    .ADDR_W(SRAM1_ADDR_W)
  ) u_writeback (
    .clk(clk),
    .rst_n(rst_n),
    .cfg_start_pass(cu_start_pass),
    .cfg_ker_idx(cu_kernel_idx),
    .sa_valid(cu_systolic_valid),
    .sa_wdata(sa_out_data),
    .busy(sa_wb_busy),
    .sram_en(sram1_p0_en),
    .sram_we(sram1_p0_we),
    .sram_addr(sram1_p0_addr),
    .sram_wdata(sram1_p0_wdata),
    .sram_wmask(sram1_p0_wmask)
  );

  // ============================================
  // Drain (SRAM1 -> DRAM)
  // ============================================
  // Calculate total pixels: (N-K+1) * (N-K+1)
  wire [6:0] output_dim = cfg_N - cfg_K + 1;
  wire [13:0] total_pixels = {7'd0, output_dim} * {7'd0, output_dim};
  wire cfg_split_mode = (cfg_K > SA_DIM);
  dl_drain_stream #(
    .ADDR_W(SRAM1_ADDR_W)
  ) u_drain (
    .clk(clk),
    .rst_n(rst_n),
    .start(cu_start_drain),
    .cfg_num_pixels(total_pixels[SRAM1_ADDR_W-1:0]),
    .cfg_output_dim(output_dim),
    .cfg_split_mode(cfg_split_mode),
    .done(cu_drain_done),
    .sram_en(sram1_p1_en),
    .sram_addr(sram1_p1_addr),
    .sram_rdata(sram1_p1_rdata),
    .tx_valid(tx_valid),
    .tx_data(tx_data),
    .tx_ready(tx_ready)
  );

  // ============================================
  // SRAM0 Arbitration
  // ============================================
  wire dma_active = dma_sram_we;

  assign sram0_p0_en    = dma_active ? dma_sram_en    : reader_p0_en;
  assign sram0_p0_we    = dma_active ? dma_sram_we    : 1'b0;
  assign sram0_p0_addr  = dma_active ? dma_sram_addr  : reader_p0_addr;
  assign sram0_p0_wdata = dma_active ? dma_sram_wdata : 64'd0;
  assign sram0_p0_wmask = dma_active ? dma_sram_wmask : 8'h00;

  assign sram0_p1_en    = reader_p1_en;
  assign sram0_p1_addr  = reader_p1_addr;

  // ============================================
  // SRAM Instantiations
  // ============================================

  // Input SRAM (64-bit wide)
  sram0_1rw1r_64x1024_wrapper u_sram0 (
    .clk(clk),
    `ifdef USE_POWER_PINS
      .vccd1(vccd1),
      .vssd1(vssd1),
    `endif
    .p0_en(sram0_p0_en),
    .p0_we(sram0_p0_we),
    .p0_addr(sram0_p0_addr),
    .p0_wdata(sram0_p0_wdata),
    .p0_wmask(sram0_p0_wmask),
    .p0_rdata(sram0_p0_rdata),
    .p1_en(sram0_p1_en),
    .p1_addr(sram0_p1_addr),
    .p1_rdata(sram0_p1_rdata)
  );

  // Output SRAM (32-bit wide)
  // Port 0: Writeback (Write Only used)
  // Port 1: Drain (Read Only used)
  sram1_1rw1r_32x4096_wrapper u_sram1 (
    .clk(clk),
    `ifdef USE_POWER_PINS
      .vccd1(vccd1),
      .vssd1(vssd1),
    `endif
    .p0_en(sram1_p0_en),
    .p0_we(sram1_p0_we),
    .p0_addr(sram1_p0_addr),
    .p0_wdata(sram1_p0_wdata),
    .p0_wmask(sram1_p0_wmask),
    .p0_rdata(sram1_p0_rdata),
    .p1_en(sram1_p1_en),
    .p1_addr(sram1_p1_addr),
    .p1_rdata(sram1_p1_rdata)
  );

endmodule
