AhmedSobhy01/convolution-accelerator/rtl/data-loader-agu/src/kernel_window_streamer.v

`timescale 1ns/1ps

module kernel_and_window_streamer #(
  parameter BYTE_ADDR_W = 13,
  parameter KER_BASE_BYTE = 16'd4096,
  parameter IMG_BASE_BYTE = 16'd0
)(
  input  wire         clk,
  input  wire         rst_n,

  input  wire [6:0]   cfg_N,
  input  wire [4:0]   cfg_K,

  input  wire         start_load_kernel,
  input  wire [1:0]   kernel_idx,
  output reg          kernel_done,

  input  wire         start_stream_window,
  input  wire [6:0]   window_col,
  output reg          window_done,

  output wire         w_valid,
  output wire [63:0]  w_data,
  output wire         p_valid,
  output wire [63:0]  p_data,

  output reg                      reader_req_valid,
  output reg  [BYTE_ADDR_W-1:0]   reader_byte_addr,
  output reg  [2:0]               reader_len_bytes,
  input  wire                     reader_req_ready,
  input  wire                     reader_resp_valid,
  input  wire [63:0]              reader_resp_data
);

  wire [15:0] N16 = {9'd0, cfg_N};
  wire [15:0] K16 = {11'd0, cfg_K};

  wire [15:0] row_bytes = N16;
  wire [15:0] col_bytes = K16;

  wire [15:0] k_lo  = K16 >> 1;            // floor(K/2)
  wire [15:0] k_hi  = K16 - k_lo;          // ceil(K/2)
  wire        k_big = (cfg_K > 5'd8);

  // Which half in rows?
  wire ker_top = (kernel_idx == 2'd0) || (kernel_idx == 2'd1);
  wire ker_bot = (kernel_idx == 2'd2) || (kernel_idx == 2'd3);

  // Which half in columns?
  wire ker_left  = (kernel_idx == 2'd0) || (kernel_idx == 2'd2);
  wire ker_right = (kernel_idx == 2'd1) || (kernel_idx == 2'd3);

  // Row range
  wire [15:0] ker_row_start = (!k_big) ? 16'd0 :
                              (ker_top ? 16'd0 : k_lo);

  wire [15:0] ker_rows_total = (!k_big) ? K16 :
                              (ker_top ? k_lo : k_hi);

  // Column offset + length
  wire [15:0] ker_col_off  = (!k_big) ? 16'd0 :
                            (ker_left ? 16'd0 : k_lo);

  wire [2:0]  ker_len_bytes = (!k_big) ? cfg_K[2:0] :
                              (ker_left ? k_lo[2:0] : k_hi[2:0]);

  wire img_is_top = (kernel_idx == 2'd0) || (kernel_idx == 2'd1);

  wire [15:0] img_row_start = img_is_top ? 16'd0 : k_lo;
  wire [15:0] img_rows_total = N16 - ((k_big) ?  k_lo : 16'd0);

  localparam IDLE        = 2'd0;
  localparam LOAD_KERNEL = 2'd1;
  localparam STREAM_WIN  = 2'd2;

  reg [1:0] state;
  reg [4:0] col_cnt;       // requests issued
  reg [4:0] col_resp_cnt;  // responses received
  reg [6:0] row_cnt;
  reg [6:0] row_resp_cnt;

  wire [15:0] ker_row = ker_row_start + col_cnt;

  wire [15:0] ker_col_addr = KER_BASE_BYTE + ker_row * col_bytes + ker_col_off;
  wire [15:0] img_row_addr = IMG_BASE_BYTE + window_col + (img_row_start + row_cnt) * row_bytes;

  wire [2:0] img_len_bytes =
    (!k_big) ? cfg_K[2:0] :
    (ker_right ? k_hi[2:0] : k_lo[2:0]);

  assign w_valid = (state == LOAD_KERNEL) & reader_resp_valid;
  assign p_valid = (state == STREAM_WIN)  & reader_resp_valid;
  assign w_data = reader_resp_data;
  assign p_data = reader_resp_data;

  wire kernel_last =
  reader_resp_valid &&
  (state == LOAD_KERNEL) &&
  (col_resp_cnt + 2'b10 == ker_rows_total);

  wire window_last =
    reader_resp_valid &&
    (state == STREAM_WIN) &&
    (row_resp_cnt + 2'b10 == img_rows_total);


  always @(posedge clk or negedge rst_n) begin
    if (!rst_n) begin
      state <= IDLE;
      col_cnt <= 5'd0;
      col_resp_cnt <= 5'd0;
      row_cnt <= 7'd0;
      row_resp_cnt <= 7'd0;
      reader_req_valid <= 1'b0;
      reader_byte_addr <= {BYTE_ADDR_W{1'b0}};
      reader_len_bytes <= 3'd0;
      kernel_done <= 1'b0;
      window_done <= 1'b0;
    end else begin
      // Default: deassert done flags
      kernel_done <= kernel_last;
      window_done <= window_last;

      // Capture responses (happens in parallel with request issuing)
      if (reader_resp_valid) begin
        if (state == LOAD_KERNEL) begin
          col_resp_cnt <= col_resp_cnt + 1'b1;

        end else if (state == STREAM_WIN) begin
          row_resp_cnt <= row_resp_cnt + 1'b1;
        end
      end

      // State machine: issue requests
      case (state)
        IDLE: begin
          col_cnt <= 5'd0;
          col_resp_cnt <= 5'd0;
          row_cnt <= 7'd0;
          row_resp_cnt <= 7'd0;
          reader_req_valid <= 1'b0;

          if (start_load_kernel) begin
            state <= LOAD_KERNEL;
          end else if (start_stream_window) begin
            state <= STREAM_WIN;
          end
        end

        LOAD_KERNEL: begin
          // Issue requests every cycle until done
          if (col_cnt < ker_rows_total) begin
            reader_byte_addr <= ker_col_addr;
            reader_len_bytes <= ker_len_bytes;
            reader_req_valid <= 1'b1;
            col_cnt <= col_cnt + 1'b1;
          end else begin
            reader_req_valid <= 1'b0;
            // Wait for all responses, then go idle
            if (col_resp_cnt + 1 >= ker_rows_total) begin
              state <= IDLE;
            end
          end
        end

        STREAM_WIN: begin
          if (row_cnt < img_rows_total) begin
            reader_byte_addr <= img_row_addr;
            reader_len_bytes <= img_len_bytes;
            reader_req_valid <= 1'b1;
            row_cnt <= row_cnt + 1'b1;
          end else begin
            reader_req_valid <= 1'b0;
            // Wait for all responses, then go idle
            if (row_resp_cnt + 1 >= img_rows_total) begin
              state <= IDLE;
            end
          end
        end

        default: state <= IDLE;
      endcase
    end
  end

endmodule
