AhmedSobhy01/convolution-accelerator/rtl/sram_blackbox.v

`timescale 1ns/1ps

// Black box stub for sky130_sram_1kbyte_1rw1r_32x256_8
// 32-bit wide, 256 words, 1RW + 1R ports
(* blackbox *)
module sky130_sram_1kbyte_1rw1r_32x256_8(
    vccd1,
    vssd1,
    clk0, csb0, web0, wmask0, addr0, din0, dout0,
    clk1, csb1, addr1, dout1
);

    inout vccd1;
    inout vssd1;
    input  clk0;
    input  csb0;
    input  web0;
    input  [3:0] wmask0;
    input  [7:0] addr0;
    input  [31:0] din0;
    output [31:0] dout0;
    input  clk1;
    input  csb1;
    input  [7:0] addr1;
    output [31:0] dout1;

endmodule

// Black box stub for sky130_sram_2kbyte_1rw1r_32x512_8
// 32-bit wide, 512 words, 1RW + 1R ports
(* blackbox *)
module sky130_sram_2kbyte_1rw1r_32x512_8(
    vccd1,
    vssd1,
    clk0, csb0, web0, wmask0, addr0, din0, dout0,
    clk1, csb1, addr1, dout1
);

    inout vccd1;
    inout vssd1;
    input  clk0;
    input  csb0;
    input  web0;
    input  [3:0] wmask0;
    input  [8:0] addr0;
    input  [31:0] din0;
    output [31:0] dout0;
    input  clk1;
    input  csb1;
    input  [8:0] addr1;
    output [31:0] dout1;

endmodule

// Black box stub for sky130_sram_1kbyte_1rw1r_8x1024_8
// 8-bit wide, 1024 words, 1RW + 1R ports
(* blackbox *)
module sky130_sram_1kbyte_1rw1r_8x1024_8(
    vccd1,
    vssd1,
    clk0, csb0, web0, wmask0, addr0, din0, dout0,
    clk1, csb1, addr1, dout1
);

    inout vccd1;
    inout vssd1;
    input  clk0;
    input  csb0;
    input  web0;
    input  [1:0] wmask0;
    input  [9:0] addr0;
    input  [7:0] din0;
    output [7:0] dout0;
    input  clk1;
    input  csb1;
    input  [9:0] addr1;
    output [7:0] dout1;

endmodule
