AhmedSobhy01/convolution-accelerator/(commit log)

2025-12-12 fix: outputs size to use input width
    [systolic_array.v]
2025-12-12 fix: set missing signals in case of reset for ps tb
    [pe_tb.v]
2025-12-17 feat: split SRAM two two
    [macro.cfg]
2025-12-17 fix: remove unused reg
    [pe.v]
2025-12-18 feat: initial design
    [macro.cfg]
2025-12-18 feat: add compute stage
2025-12-18 feat: add delay before resetting input in systolic array testbench
    [systolic_array_tb.v]
2025-12-18 hotfix: add power pins and fix undefined value in active_k_dim
2025-12-19 fix: working byte window streamer
    [byte_window_streamer.v, simple_ram_models.v, tb_window_streamer.v]
2025-12-19 feat: update unaligned_memory_reader and testbench for power pin integration and response handling
2025-12-19 feat: single stage pipelined window streamer
2025-12-19 fix: revert byte window streamer to use bhevioral model
    [byte_window_streamer.v, tb_top_module.v]
2025-12-19 fix: handle odd kernel
    [dl_dma_rx.v, tb_top_module.v]
2025-12-19 refactor: remove unused power pin wires and clean up testbench code
2025-12-19 fix: correct img_rows_total calculation for kernel size handling
    [kernel_window_streamer.v]
2025-12-20 fix: fix drain test in the the top file tb
    [conv_accelerator_top.v]
2025-12-20 fix: adjust dram size
    [tb_conv_accel_simple.v]
2025-12-20 feat: add read_data.py to process input data and print it
2025-12-20 fix: systolic array testbench to match kernel loading from top
    [systolic_array_tb.v]
2025-12-20 Refactor control unit signals and enhance simulation scripts
    - Changed `start_loading_data_to_sram` from reg to wire in control_unit.v for better signal handling.
    - Removed unnecessary assignments for `start_loading_data_to_sram` in the control unit state machine.
    - Updated conditions for `systolic_data_valid` to improve logic clarity.
    - Modified output data assignment in conv_accelerator_top.v to cap values at 255.
    - Adjusted signal conditions for `sa_valid` to use logical OR instead of AND.
    - Enhanced run_simple.do script with detailed comments and organized waveforms for better readability and analysis.
    - Improved waveform capture in the simulation script, adding more detailed sections fo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
2025-12-20 fix: remove hardcoded `sa_out_valid`
    [conv_accelerator_top.v]
2025-12-20 feat: update testbench to take from three files
    [config.txt]
2025-12-20 Add new test cases and verification scripts for convolution operations
    - Introduced multiple test cases including advanced throughput, partial tile, and saturation configurations.
    - Added input, weight, and gold standard hex files for each test case.
    - Implemented a batch verification script (`verify_all.py`) to automate the testing process for all convolution cases.
    - Created a detailed verification script (`verify_convolution.py`) that reads configuration, input, weight, and gold files, performs convolution, and compares results.
    - Ensured all new files are properly formatted and structured for easy integration into the testing framework.
    [01_Basic_Minimal_config.txt, 02_Basic_Identity_config.txt, 03_Basic_AllOnes_config.txt, 04_Regular_Standard_config.txt, 05_Regular_LargeHalo_config.txt, 06_Regular_PingPong_config.txt, 07_Adv_MaxSpec_config.txt, 08_Adv_Throughput_config.txt]
2025-12-20 feat: remove obsolete configuration and input files for convolution tests
    [config.txt]
2025-12-20 fix: make tx_data 8 bits
    [conv_accelerator_top.v]
2025-12-21 style: update test case output formatting for clarity
2025-12-21 feat: update configuration and add black box models for SRAM components
    [macro_placement.cfg]
2025-12-21 feat: update die and core area dimensions, adjust GRT parameters, and modify cell padding in configuration files
    [macro_placement.cfg]
2025-12-21 feat: update configuration files for SRAM macros and adjust die/core area dimensions
    [macro_placement.cfg]
2025-12-21 feat: update macro placement configuration to reflect Yosys flattened hierarchy
    [macro_placement.cfg]
2025-12-21 feat: correct SRAM macro hierarchy references in macro placement configuration
    [macro_placement.cfg]
2025-12-21 Refactor RTL directory structure and remove obsolete testbenches
    - Updated paths in `run_simple.do` to reflect new RTL directory structure.
    - Deleted `tb_conv_accel_simple_4_bytes.v` and `tb_conv_accelerator.v` testbench files as they are no longer needed.
    - Ensured all relevant modules are compiled from the new RTL paths.
    [macro.cfg]
2025-12-21 feat: adjust conditions for row counters and update output wire declarations in control unit and kernel streamer
2025-12-21 feat: update configuration parameters for clock period, die and core area, and GRT settings
    [macro_placement.cfg]
2026-07-21 fix: integrate SRAM macros with USE_POWER_PINS guards and blackbox netlists
    [conv_accelerator_top.v, dl_drain_stream.v, memory_generator_sky130_32_4096_1.v, memory_generator_sky130_64_1024_2.v, sram0_wrapper.v, sram1_wrapper.v, sram_blackbox.v, sram_blackbox_32x256.v]
2026-07-23 docs: RTL-to-GDS flow docs and 80ns OpenLane signoff config
